titetil/hp-bldc-pcb/Gerbers/Bill of Materials.xlsx

Sheet: BOM v1.0
 | Qty | Part Number | Description | Manufacturer | Refdef
1 | 2 | SBC817-40LT1G | TRANS NPN 45V 0.5A SOT-23 | ON SEMICONDUCTOR | T102,T103
2 | 1 | SBAV99LT1G | DIODE ARRAY 100V 215MA SOT23-3 | ON SEMICONDUCTOR | D103
3 | 1 | AC0805JR-0710RL | RES SMD 10 OHM 5% 1/8W 0805 | YAGEO | R671
4 | 11 | AC0603FR-0710KL | RES SMD 10K OHM 1% 1/10W 0603 | YAGEO | R108,R111,R114,R401,R608,R609,R638,R639,R668,R669,R672
5 | 3 | AC0603FR-071KL | RES SMD 1K OHM 1% 1/10W 0603 | YAGEO | R601,R631,R661
6 | 3 | AC0603JR-070RL | RES SMD 0 OHM JUMPER 1/10W 0603 | YAGEO | R602,R632,R662
7 | 10 | AC0603FR-0747K5L | RES SMD 47.5K OHM 1% 1/10W 0603 | YAGEO | R102,R109,R110,R112,R605,R607,R635,R637,R665,R667
8 | 1 | NTCS0805E3153JMT | NTC THERMISTOR 15K OHM 5% 0805 | VISHAY | R404
9 | 1 | MCP1790-5002E/DB | IC REG LINEAR 5V 70MA SOT223-3 | MICROCHIP | IC101
10 | 1 | PIC16F1936-I/SS | IC MCU 8BIT 14KB FLASH 28SSOP | MICROCHIP | IC401
11 | 3 | BTN8962TAAUMA1 | IC MOTOR DRIVER PAR TO263-7 | INFINEON | IC601,IC631,IC661
12 | 2 | AC0805KRX7R0BB223 | CAP CER 0.022UF 100V X7R 0805 | YAGEO | C101,C102
13 | 1 | CL21B103KC6WPNC | CAP CER 10000PF 100V X7R 0805 | SAMSUNG | C111
14 | 2 | CL31B225KBHVPNE | CAP CER 2.2UF 50V X7R 1206 | SAMSUNG | C103,C104
15 | 4 | C0603C101J5GACAUTO | CAP CER 100PF 50V C0G/NP0 0603 | KEMET | C401,C402,C403,C404, C668
16 | 6 | C0805C105K3RACAUTO | CAP CER 1UF 25V X7R 0805 | KEMET | C601,C602,C631,C632,C661,C662
17 | 1 | C1206C106K4RACAUTO | CAP CER 10UF 16V X7R 1206 | KEMET | C109
18 | 4 | C0603C102K5RACAUTO | CAP CER 1000PF 50V X7R 0603 | KEMET | C112,C603,C633,C663
19 | 1 | C0603C222K5RACAUTO | CAP CER 2200PF 50V X7R 0603 | KEMET | C116
20 | 1 | GCM219R72A682KA37D | CAP CER 6800PF 100V X7R 0805 | MURATA | C110
21 | 7 | CL10B103KC8WPNC | CAP CER 10000PF 100V X7R 0603 | SAMSUNG | C108,C113,C114,C115,C405,C407,C408
22 | 3 | EEE-FK1V331P | CAP ALUM 330UF 20% 35V SMD | PANASONIC | C105,C106,C107
23 | 1 | BAS2103WE6327HTSA1 | DIODE GEN PURP 200V 250MA SOD323 | INFINEON | D104
24 | 2 | BAS40-04,215 | DIODE ARRAY SCHOTTKY 40V SOT23 | NEXPERIA | D102, D1
25 | 4 | AC0603FR-0722K1L | RES SMD 22.1K OHM 1% 1/10W 0603 | YAGEO | R113,R610,R640,R670
26 | 3 | ERJ-3EKF7151V | RES SMD 7.15K OHM 1% 1/10W 0603 | PANASONIC | R606,R636,R666
27 | 1 | ERJ-3EKF2371V | RES SMD 2.37K OHM 1% 1/10W 0603 | PANASONIC | R402
28 | 1 | ERJ-14NF1501U | RES SMD 1.5K OHM 1% 1/2W 1210 | PANASONIC | R104
29 | 1 | CRCW06036R81FKEA | RES SMD 6.81 OHM 1% 1/10W 0603 | VISHAY DALE | R107
30 | 1 | ERJ-3EKF9091V | RES SMD 9.09K OHM 1% 1/10W 0603 | PANASONIC | R103
31 | 3 | BLM18AG102SN1D | FERRITE BEAD 1 KOHM 0603 1LN | MURATA | L102,L103,L104
32 | 1 | 7443551200 | FIXED IND 2UH 23A 2.6 MOHM SMD | WURTH | L101
33 | 1 | TSM-105-03-T-SV | CONN HEADER 5POS 0.1" SMD | SAMTEC | ST401
34
35

Sheet: Board Revision History
Version | Description
1.0 | Inital Release

Sheet: Issues
# | Issues | Fixed? | Rev
