titetil/hp-bldc-pcb/hp-bldc-pcb_3D/TO-263-7_TabPin8.step

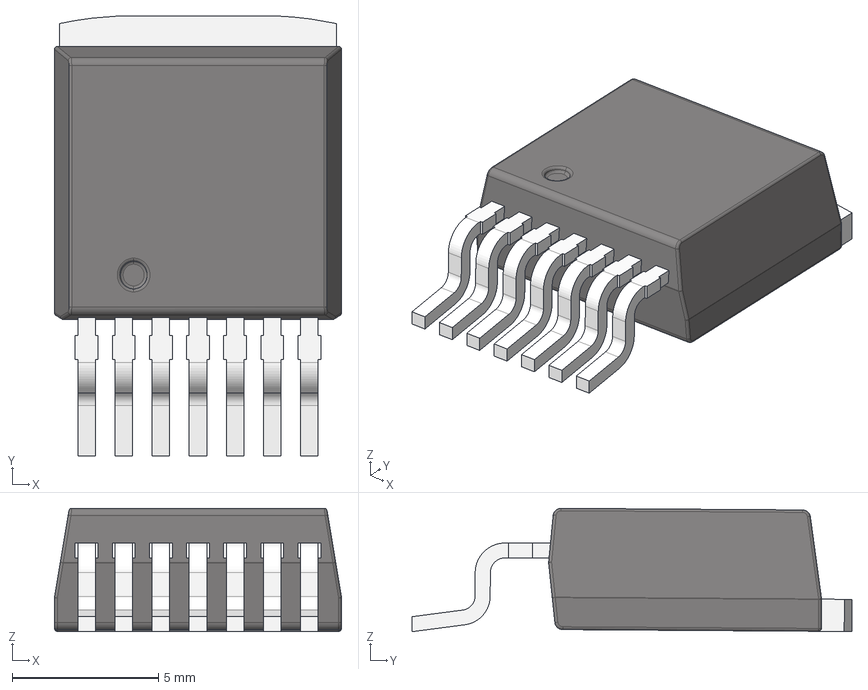
[picture p1: CAD file, 2018-06-19]
hp-bldc-pcb_3D/TO-263-7_TabPin8.step
9.82 x 15.1 x 4.22 mm
Document
Document001
Document002
Document003
Document004
Document005
Document006
Document007
Document008
