titetil/hp-bldc-pcb/hp_bldc_pcb.FCStd

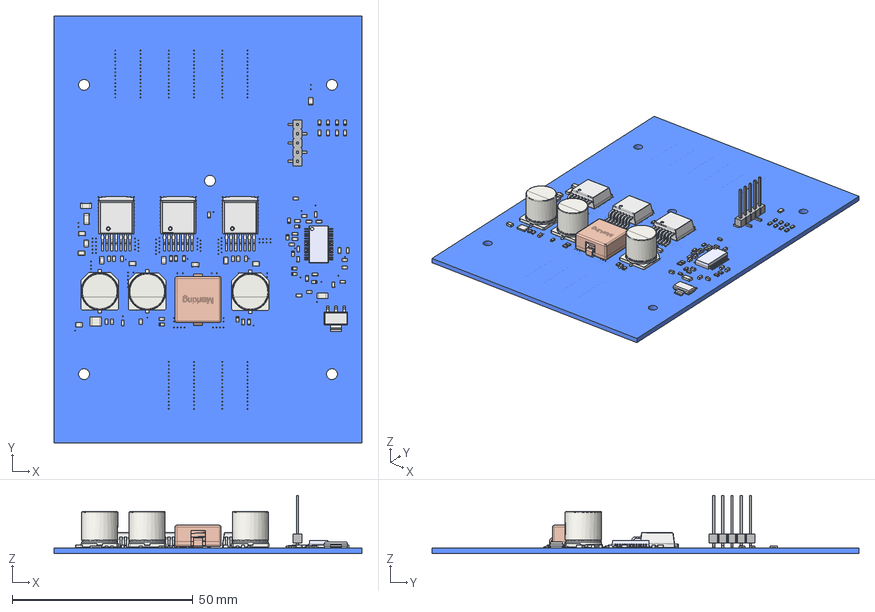
[picture p2: CAD file, 2018-06-19]
hp_bldc_pcb.FCStd
85.1 x 118.1 x 16.1 mm
Pcb
CP_Elec_10x10_
C_0805_
C_0805_001
C_1206_
C_1206_001
C_1206_002
C_0805_002
C_0805_003
C_0603_
C_0603_001
C_0603_002
C_0603_003
C_0603_004
C_0603_005
C_0603_006
C_0603_007
C_0603_008
C_0603_009
C_0603_010
C_0603_011
C_0805_004
C_0805_005
C_0603_012
C_0805_006
C_0805_007
C_0603_013
C_0805_008
C_0805_009
C_0603_014
C_0603_015
SSOP-28_5.3x10.2mm_Pitch0.65mm_
R_0603_
R_0603_001
R_1210_
R_0603_002
R_0603_003
R_0603_004
R_0603_005
R_0603_006
R_0603_007
R_0603_008
R_0603_009
R_0603_010
R_0603_011
R_0603_012
R_0603_013
R_0603_014
R_0603_015
R_0603_016
R_0603_017
R_0603_018
R_0603_019
R_0603_020
R_0603_021
R_0603_022
R_0603_023
R_0603_024
R_0603_025
R_0603_026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
