titetil/hp-bldc-pcb/(list of files, cad)

Other CAD files:
hp-bldc-pcb_3D/SSOP-28_5.3x10.2mm_Pitch0.65mm.step
