titetil/hp-bldc-pcb/hp-bldc-pcb.kicad_pcb

## KiCad design hp-bldc-pcb.kicad_pcb (2018-10-08)

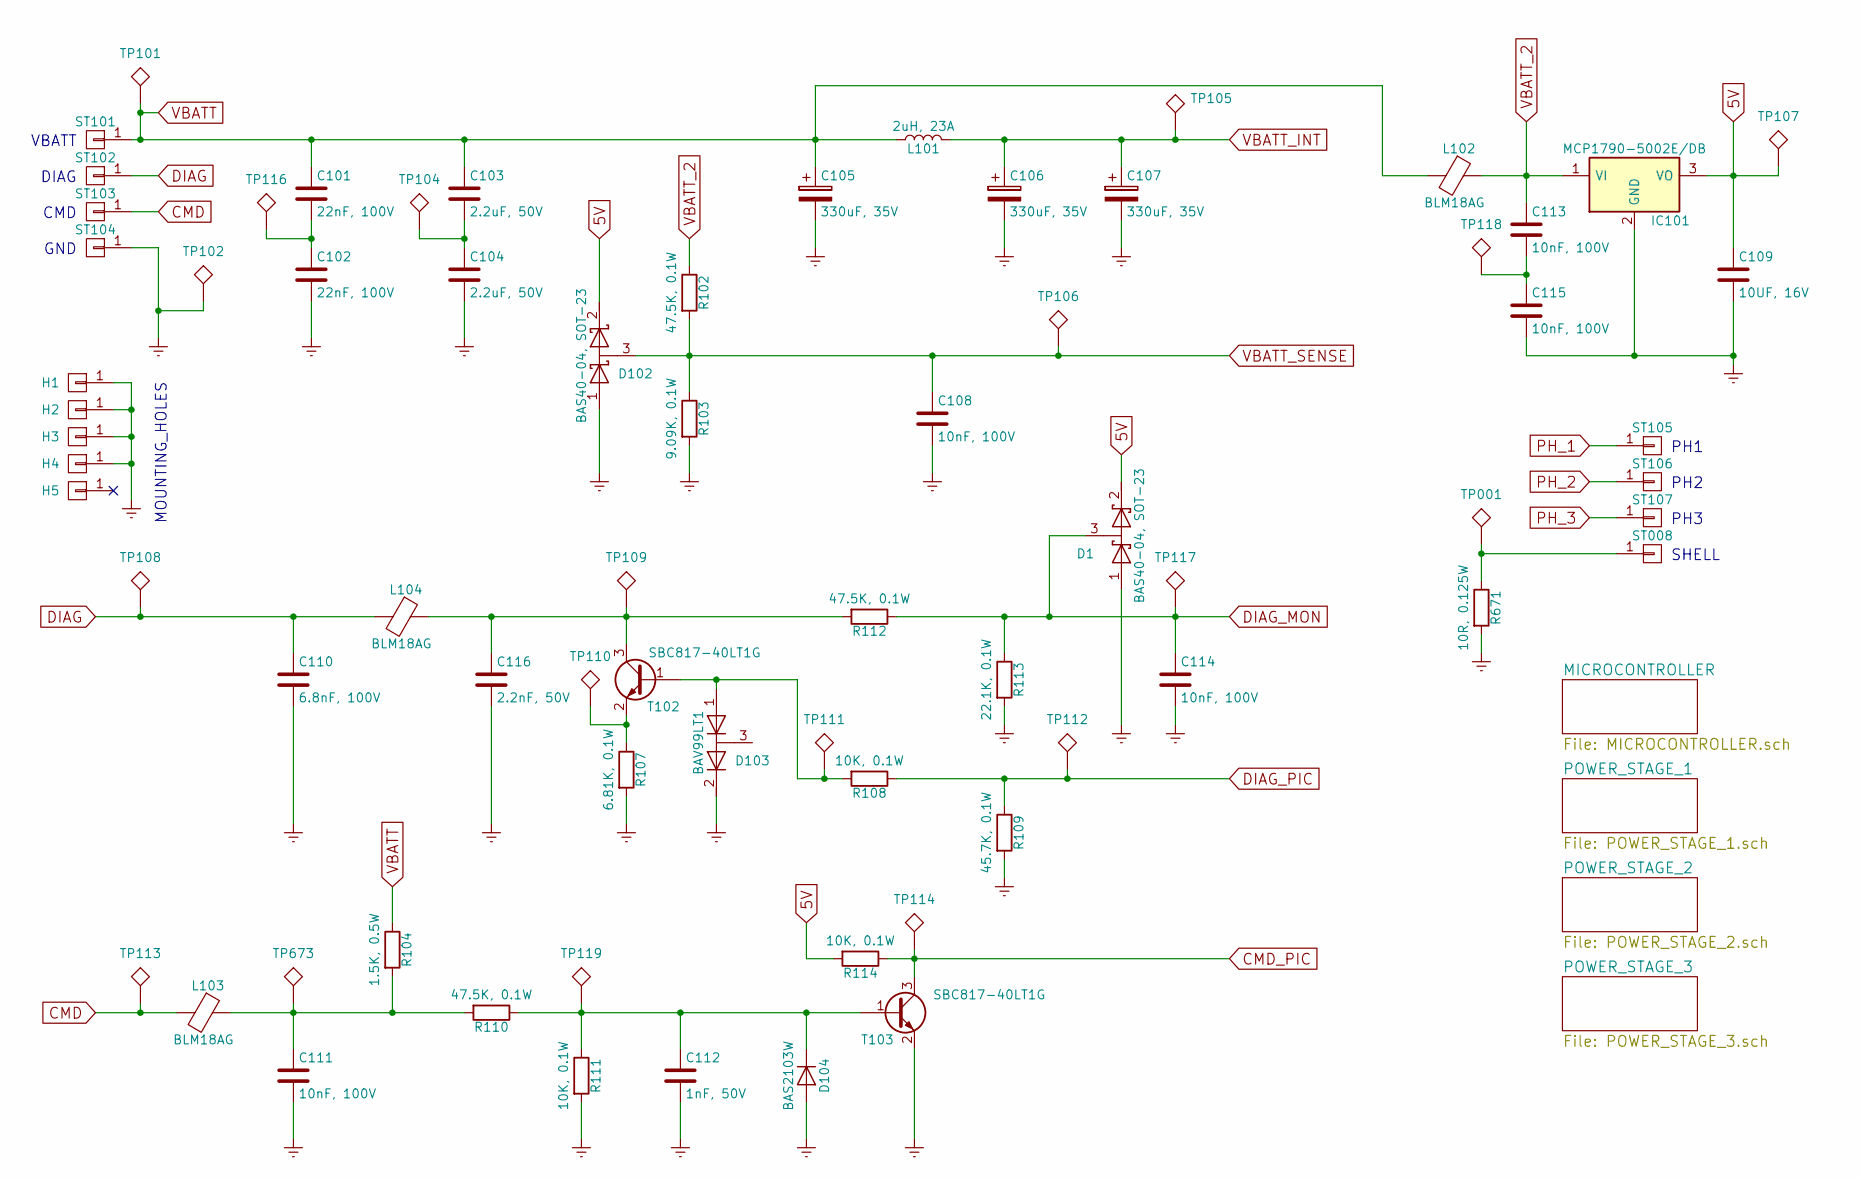
[picture p14: schematic hp-bldc-pcb.sch]

Parts:
C101, C102: 22nF, 100V; C_0805
C103, C104: 2.2uF, 50V; C_1206
C105, C106, C107: 330uF, 35V; CP_Elec_10x10
C108, C113, C114, C115: 10nF, 100V; C_0603
C109: 10UF, 16V; C_1206
C110: 6.8nF, 100V; C_0805
C111: 10nF, 100V; C_0805
C112: 1nF, 50V; C_0603
C116: 2.2nF, 50V; C_0603
D1, D102: BAS40-04, SOT-23; SOT-23
D103: BAV99LT1; SOT-23
D104: BAS2103W; D_SOD-323
H1, H2, H3, H4, H5: CONN_01X01; ENCLOSURE_MOUNTING_HOLE
IC101: MCP1790-5002E/DB; SOT-223
L101: 2uH, 23A; L_Wuerth_HCI-1365
L102, L103, L104: BLM18AG; L_0603
R102, R110, R112: 47.5K, 0.1W; R_0603
R103: 9.09K, 0.1W; R_0603
R104: 1.5K, 0.5W; R_1210
R107: 6.81K, 0.1W; R_0603
R108, R111, R114: 10K, 0.1W; R_0603
R109: 45.7K, 0.1W; R_0603
R113: 22.1K, 0.1W; R_0603
R671: 10R, 0.125W; R_0805
ST008, ST101, ST102, ST103, ST104, ST105, ST106, ST107: CONN_01X01; BIG_RECT_PAD
T102, T103: SBC817-40LT1G; SOT-23
TP001, TP101, TP102, TP104, TP105, TP106, TP107, TP108, TP109, TP110, TP111, TP112, TP113, TP114, TP116, TP117, TP118, TP119, TP673: TEST; TEST_POINT_40mil

Connections:
5V: C109.1, D1.2 (K), D102.2 (K), IC101.3 (VO), R114.2, TP107.1; also elsewhere on the board
CMD: L103.2, ST103.1, TP113.1
CMD_PIC: R114.1, T103.3 (C), TP114.1; also elsewhere on the board
DIAG: C110.1, L104.2, ST102.1, TP108.1
DIAG_MON: C114.1, D1.3 (common), R112.1, R113.1, TP117.1; also elsewhere on the board
DIAG_PIC: R108.1, R109.1, TP112.1; also elsewhere on the board
Earth: C102.2, C104.2, C105.2, C106.2, C107.2, C108.2, C109.2, C110.2, C111.2, C112.2, C114.2, C115.2, C116.2, D1.1 (A), D102.1 (A), D103.2 (K), D104.2 (A), H1.1, H2.1, H3.1, H4.1, IC101.2 (GND), IC101.4 (GND), R103.2, R107.2, R109.2, R111.2, R113.2, R671.2, ST104.1, T103.2 (E), TP102.1; also elsewhere on the board
unnamed: C101.2, C102.1, TP116.1
unnamed: C103.2, C104.1, TP104.1
unnamed: C111.1, L103.1, R104.2, R110.2, TP673.1
unnamed: C112.1, D104.1 (K), R110.1, R111.1, T103.1 (B), TP119.1
unnamed: C113.2, C115.1, TP118.1
unnamed: C116.1, L104.1, R112.2, T102.3 (C), TP109.1
unnamed: D103.1 (A), R108.2, T102.1 (B), TP111.1
unnamed: R107.1, T102.2 (E), TP110.1
unnamed: R671.1, ST008.1, TP001.1
PH_1: ST105.1; also elsewhere on the board
PH_2: ST106.1; also elsewhere on the board
PH_3: ST107.1; also elsewhere on the board
VBATT: C101.1, C103.1, C105.1, L101.1, L102.2, R104.1, ST101.1, TP101.1
VBATT_2: C113.1, IC101.1 (VI), L102.1, R102.1
VBATT_INT: C106.1, C107.1, L101.2, TP105.1; also elsewhere on the board
VBATT_SENSE: C108.1, D102.3 (common), R102.2, R103.1, TP106.1; also elsewhere on the board

Notes on the sheet:
PH1
PH2
PH3
SHELL
VBATT
DIAG
CMD
GND
MOUNTING_HOLES

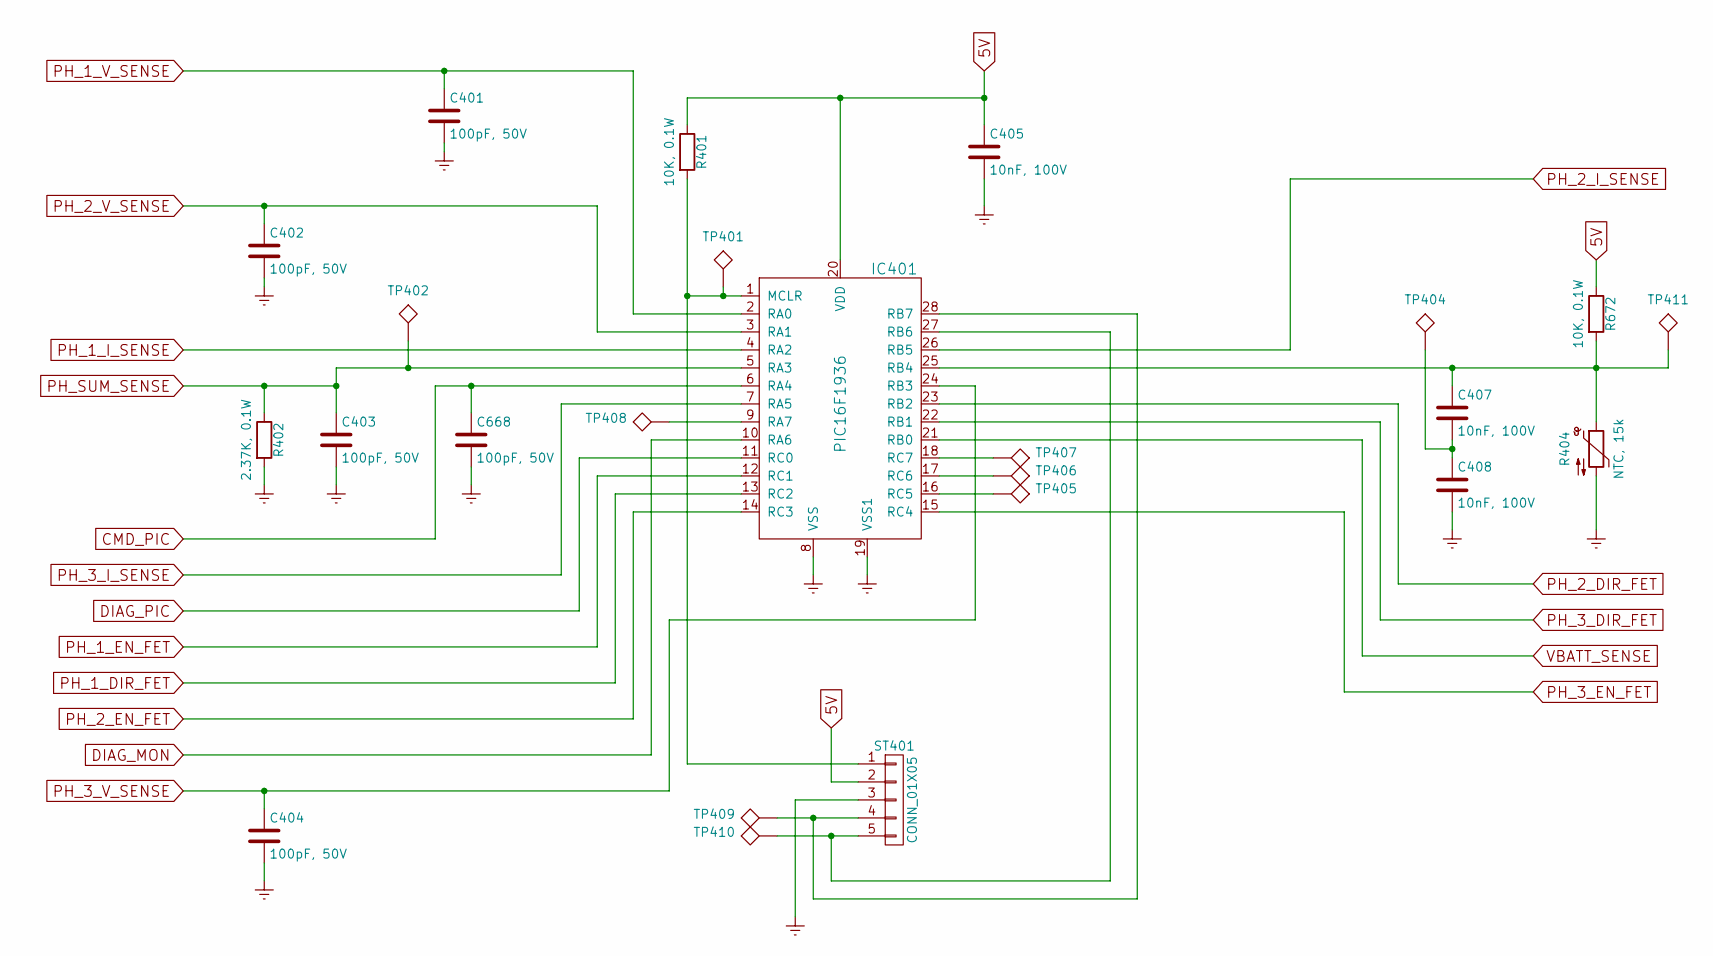
[picture p15: schematic MICROCONTROLLER.sch]

Parts:
C401, C402, C403, C404, C668: 100pF, 50V; C_0603
C405, C407, C408: 10nF, 100V; C_0603
IC401: PIC16F1936; SSOP-28_5.3x10.2mm_Pitch0.65mm
R401, R672: 10K, 0.1W; R_0603
R402: 2.37K, 0.1W; R_0603
R404: NTC, 15k; R_0603
ST401: CONN_01X05; Pin_Header_Straight_1x05_Pitch2.54mm_SMD_Pin1Left
TP401, TP402, TP404, TP405, TP406, TP407, TP408, TP409, TP410, TP411: TEST; TEST_POINT_40mil

Connections:
5V: C405.1, IC401.20 (VDD), R401.1, R672.1, ST401.2; also elsewhere on the board
CMD_PIC: C668.1, IC401.6 (RA4); also elsewhere on the board
DIAG_MON: IC401.10 (RA6); also elsewhere on the board
DIAG_PIC: IC401.11 (RC0); also elsewhere on the board
Earth: C401.2, C402.2, C403.2, C404.2, C405.2, C408.2, C668.2, IC401.8 (VSS), IC401.19 (VSS1), R402.2, R404.2, ST401.3; also elsewhere on the board
unnamed: C407.1, IC401.25 (RB4), R404.1, R672.2, TP411.1
unnamed: C407.2, C408.1, TP404.1
unnamed: IC401.1 (MCLR), R401.2, ST401.1, TP401.1
unnamed: IC401.9 (RA7), TP408.1
unnamed: IC401.16 (RC5), TP405.1
unnamed: IC401.17 (RC6), TP406.1
unnamed: IC401.18 (RC7), TP407.1
unnamed: IC401.27 (RB6), ST401.5, TP410.1
unnamed: IC401.28 (RB7), ST401.4, TP409.1
PH_1_DIR_FET: IC401.13 (RC2); also elsewhere on the board
PH_1_EN_FET: IC401.12 (RC1); also elsewhere on the board
PH_1_I_SENSE: IC401.4 (RA2); also elsewhere on the board
PH_1_V_SENSE: C401.1, IC401.2 (RA0); also elsewhere on the board
PH_2_DIR_FET: IC401.23 (RB2); also elsewhere on the board
PH_2_EN_FET: IC401.14 (RC3); also elsewhere on the board
PH_2_I_SENSE: IC401.26 (RB5); also elsewhere on the board
PH_2_V_SENSE: C402.1, IC401.3 (RA1); also elsewhere on the board
PH_3_DIR_FET: IC401.22 (RB1); also elsewhere on the board
PH_3_EN_FET: IC401.15 (RC4); also elsewhere on the board
PH_3_I_SENSE: IC401.7 (RA5); also elsewhere on the board
PH_3_V_SENSE: C404.1, IC401.24 (RB3); also elsewhere on the board
PH_SUM_SENSE: C403.1, IC401.5 (RA3), R402.1, TP402.1; also elsewhere on the board
VBATT_SENSE: IC401.21 (RB0); also elsewhere on the board

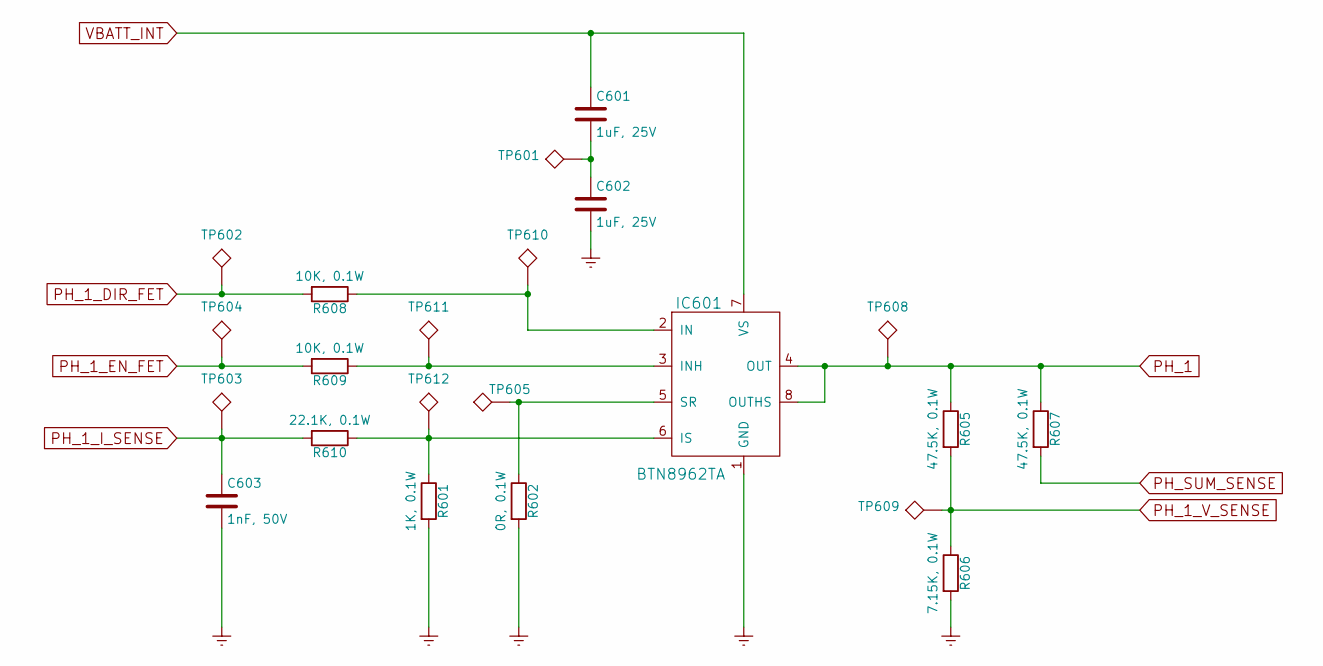
[picture p16: schematic POWER_STAGE_1.sch]

Parts:
C601, C602: 1uF, 25V; C_0805
C603: 1nF, 50V; C_0603
IC601: BTN8962TA; TO-263-7_TabPin8
R601: 1K, 0.1W; R_0603
R602: 0R, 0.1W; R_0603
R605, R607: 47.5K, 0.1W; R_0603
R606: 7.15K, 0.1W; R_0603
R608, R609: 10K, 0.1W; R_0603
R610: 22.1K, 0.1W; R_0603
TP601, TP602, TP603, TP604, TP605, TP608, TP609, TP610, TP611, TP612: TEST; TEST_POINT_40mil

Connections:
Earth: C602.2, C603.2, IC601.1 (GND), R601.2, R602.2, R606.2; also elsewhere on the board
unnamed: C601.2, C602.1, TP601.1
unnamed: IC601.2 (IN), R608.1, TP610.1
unnamed: IC601.3 (INH), R609.1, TP611.1
unnamed: IC601.5 (SR), R602.1, TP605.1
unnamed: IC601.6 (IS), R601.1, R610.1, TP612.1
PH_1: IC601.4 (OUT), IC601.8 (OUTHS), R605.1, R607.1, TP608.1; also elsewhere on the board
PH_1_DIR_FET: R608.2, TP602.1; also elsewhere on the board
PH_1_EN_FET: R609.2, TP604.1; also elsewhere on the board
PH_1_I_SENSE: C603.1, R610.2, TP603.1; also elsewhere on the board
PH_1_V_SENSE: R605.2, R606.1, TP609.1; also elsewhere on the board
PH_SUM_SENSE: R607.2; also elsewhere on the board
VBATT_INT: C601.1, IC601.7 (VS); also elsewhere on the board

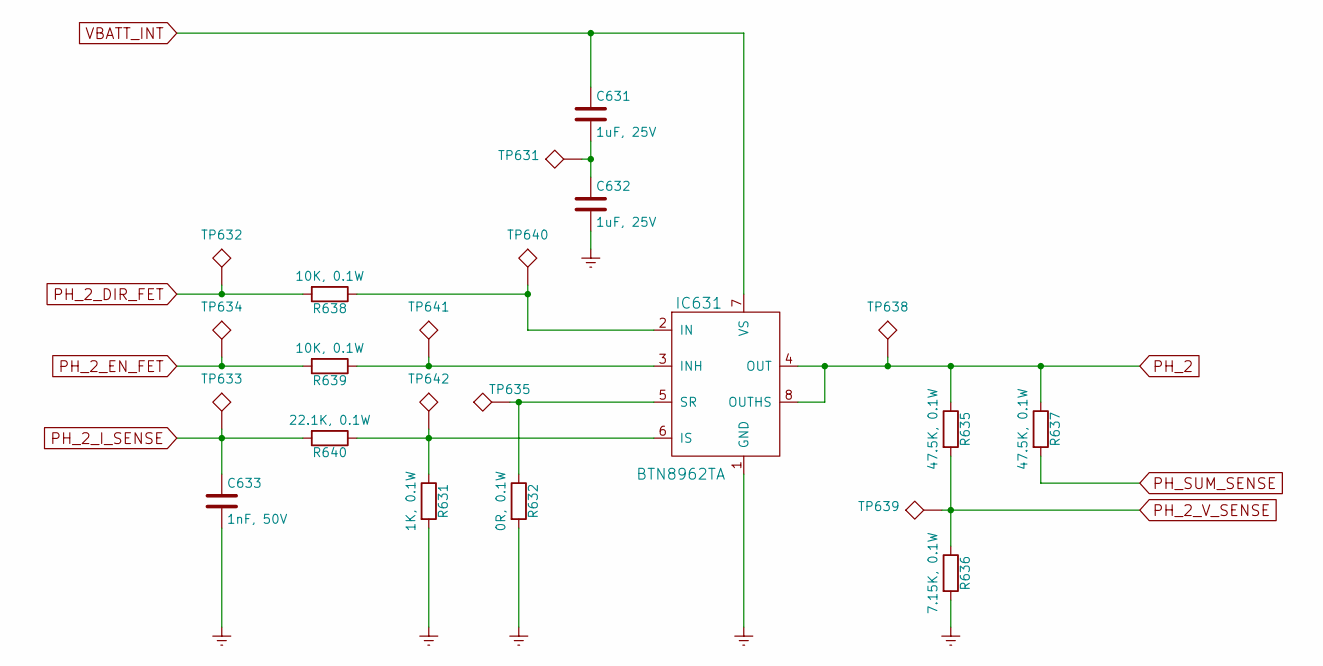
[picture p17: schematic POWER_STAGE_2.sch]

Parts:
C631, C632: 1uF, 25V; C_0805
C633: 1nF, 50V; C_0603
IC631: BTN8962TA; TO-263-7_TabPin8
R631: 1K, 0.1W; R_0603
R632: 0R, 0.1W; R_0603
R635, R637: 47.5K, 0.1W; R_0603
R636: 7.15K, 0.1W; R_0603
R638, R639: 10K, 0.1W; R_0603
R640: 22.1K, 0.1W; R_0603
TP631, TP632, TP633, TP634, TP635, TP638, TP639, TP640, TP641, TP642: TEST; TEST_POINT_40mil

Connections:
Earth: C632.2, C633.2, IC631.1 (GND), R631.2, R632.2, R636.2; also elsewhere on the board
unnamed: C631.2, C632.1, TP631.1
unnamed: IC631.2 (IN), R638.1, TP640.1
unnamed: IC631.3 (INH), R639.1, TP641.1
unnamed: IC631.5 (SR), R632.1, TP635.1
unnamed: IC631.6 (IS), R631.1, R640.1, TP642.1
PH_2: IC631.4 (OUT), IC631.8 (OUTHS), R635.1, R637.1, TP638.1; also elsewhere on the board
PH_2_DIR_FET: R638.2, TP632.1; also elsewhere on the board
PH_2_EN_FET: R639.2, TP634.1; also elsewhere on the board
PH_2_I_SENSE: C633.1, R640.2, TP633.1; also elsewhere on the board
PH_2_V_SENSE: R635.2, R636.1, TP639.1; also elsewhere on the board
PH_SUM_SENSE: R637.2; also elsewhere on the board
VBATT_INT: C631.1, IC631.7 (VS); also elsewhere on the board

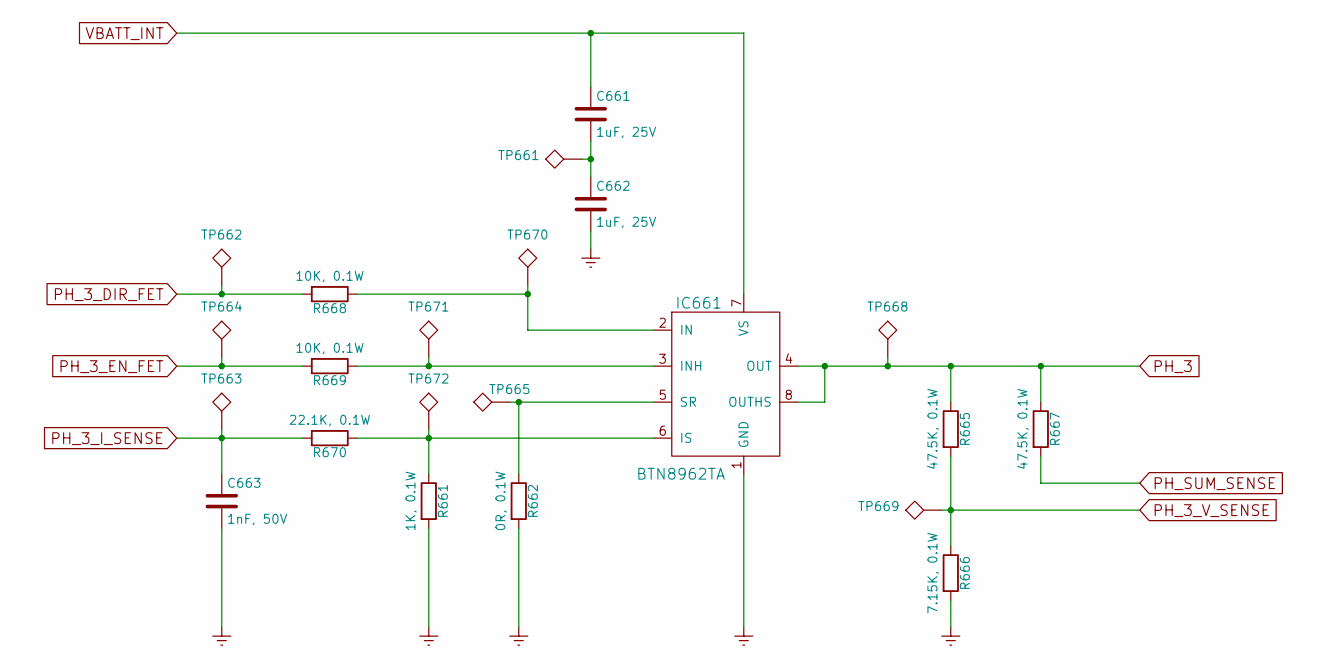
[picture p18: schematic POWER_STAGE_3.sch]

Parts:
C661, C662: 1uF, 25V; C_0805
C663: 1nF, 50V; C_0603
IC661: BTN8962TA; TO-263-7_TabPin8
R661: 1K, 0.1W; R_0603
R662: 0R, 0.1W; R_0603
R665, R667: 47.5K, 0.1W; R_0603
R666: 7.15K, 0.1W; R_0603
R668, R669: 10K, 0.1W; R_0603
R670: 22.1K, 0.1W; R_0603
TP661, TP662, TP663, TP664, TP665, TP668, TP669, TP670, TP671, TP672: TEST; TEST_POINT_40mil

Connections:
Earth: C662.2, C663.2, IC661.1 (GND), R661.2, R662.2, R666.2; also elsewhere on the board
unnamed: C661.2, C662.1, TP661.1
unnamed: IC661.2 (IN), R668.1, TP670.1
unnamed: IC661.3 (INH), R669.1, TP671.1
unnamed: IC661.5 (SR), R662.1, TP665.1
unnamed: IC661.6 (IS), R661.1, R670.1, TP672.1
PH_3: IC661.4 (OUT), IC661.8 (OUTHS), R665.1, R667.1, TP668.1; also elsewhere on the board
PH_3_DIR_FET: R668.2, TP662.1; also elsewhere on the board
PH_3_EN_FET: R669.2, TP664.1; also elsewhere on the board
PH_3_I_SENSE: C663.1, R670.2, TP663.1; also elsewhere on the board
PH_3_V_SENSE: R665.2, R666.1, TP669.1; also elsewhere on the board
PH_SUM_SENSE: R667.2; also elsewhere on the board
VBATT_INT: C661.1, IC661.7 (VS); also elsewhere on the board

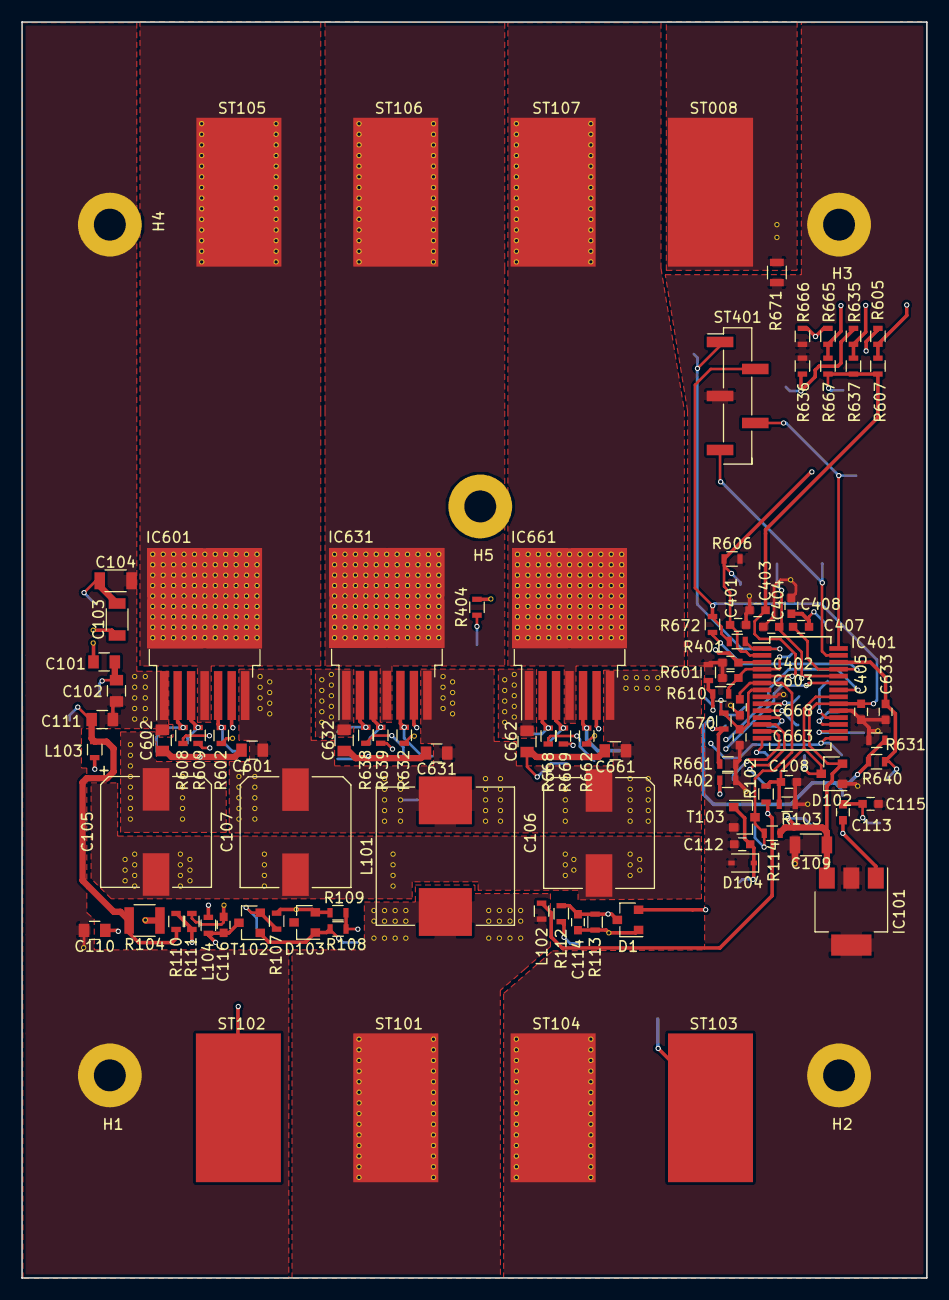
[picture p19: board hp-bldc-pcb.kicad_pcb from above]

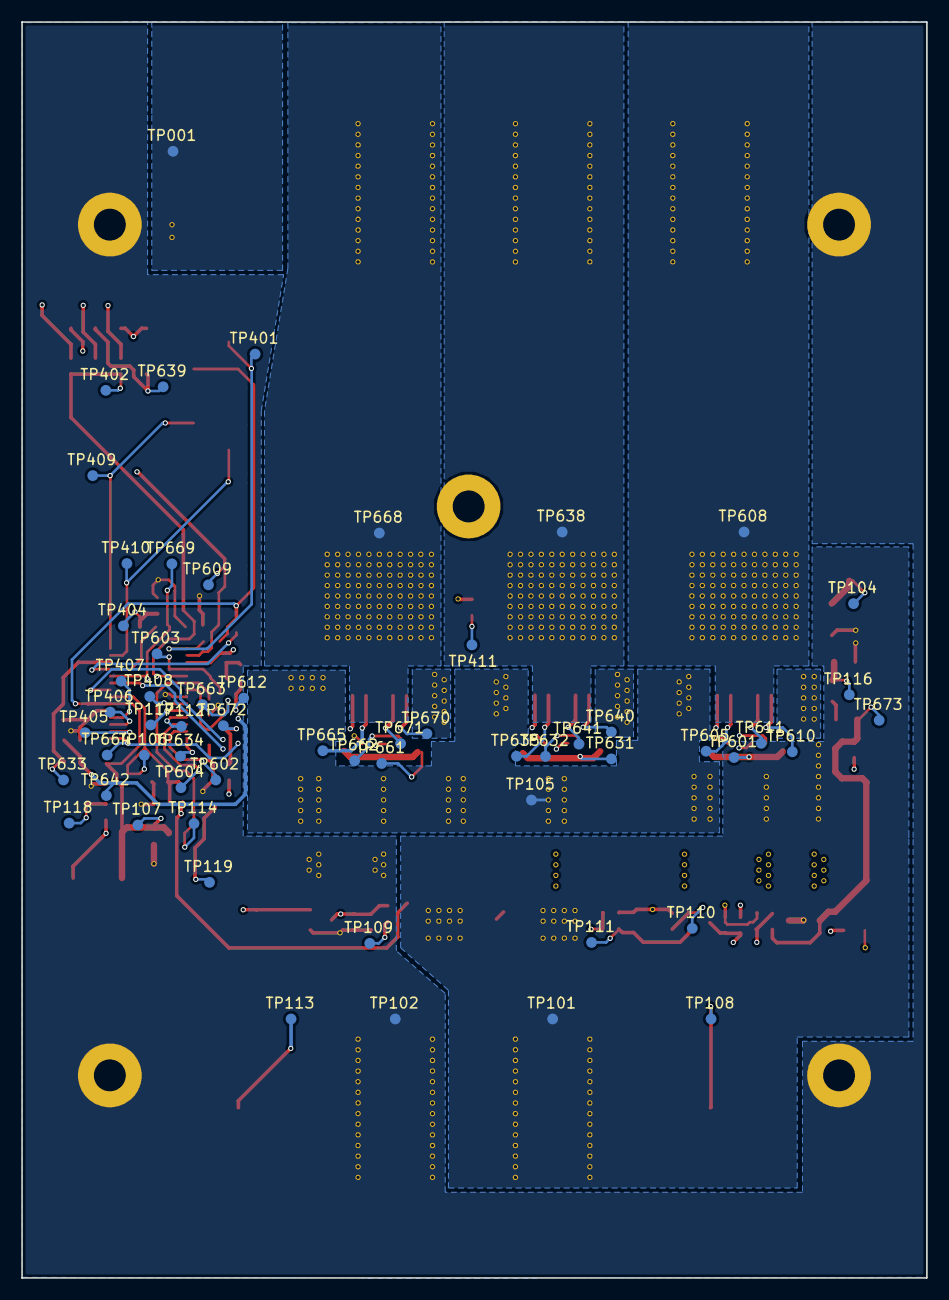
[picture p20: board hp-bldc-pcb.kicad_pcb from below]

Board: 4 copper layers, 85.1 x 118.1 mm, 161 parts (59 on the bottom side), 60 nets.
