titetil/hp-bldc-pcb/(commit log)

2018-02-06 - Initial commit.
    [MICROCONTROLLER.sch, POWER_STAGE_1.sch, POWER_STAGE_2.sch, POWER_STAGE_3.sch, hp-bldc-pcb.kicad_pcb, hp-bldc-pcb.sch]
2018-02-14 - Finished traces. Now copper areas.
    [MICROCONTROLLER.sch, POWER_STAGE_2.sch, hp-bldc-pcb.sch]
2018-02-15 - Finished putting down copper areas.
    [hp-bldc-pcb.kicad_pcb]
2018-02-15 - Almost done with PCB. Need to fix a few errors.
    [hp-bldc-pcb.kicad_pcb]
2018-02-16 - Finished v1.0
    [Bill of Materials.xlsx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]
2018-03-22 - Finished adaptation to JMS board footprint. - Added testpoints. - Changed header connector to 0.1" pitch, and tall.
    [Bill of Materials.xlsx, MICROCONTROLLER.sch, POWER_STAGE_1.sch, POWER_STAGE_2.sch, POWER_STAGE_3.sch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]
2018-06-19 - Minor changes to silkscreen. - Minor changes to BOM. - Additions to Readme file. - Page layout changed in schematic.
    [Bill of Materials.xlsx, MICROCONTROLLER.sch, POWER_STAGE_1.sch, POWER_STAGE_2.sch, POWER_STAGE_3.sch, SSOP-28_5.3x10.2mm_Pitch0.65mm.step, TO-263-7_TabPin8.step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]
2018-09-24 -Changed naming convention of gerber zip file.
    [hp-bldc-pcb.kicad_pcb]
2018-10-08 - Added TP411 at JMS request. This was needed to test the NTC during ICT.
    [MICROCONTROLLER.sch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]
